rat0mu/ISP-2027RTC/hardware/boards/README.md

# 電路板專案

狀態：尚未建立設計。

實際需要一張板時，在此新增具功能名稱的子目錄，例如 primary/、backup/ 或 power/；名稱為示例，不代表已決定板數。

每張板至少包含：
- 一份清楚的現行專案入口與工具版本。
- 原理圖、PCB 與專案必要設定。
- 本板 README：用途、版號、依賴、已知問題與檢查狀態。
- 對應的電氣與機構介面文件連結。

必要庫放在共用 libraries/ 或本板明確指定的位置。自動備份不作為正式來源。正式製造資料的保存方式見 [發布檢查表](../../docs/templates/release_checklist.md)。
