rat0mu/ISP-2027RTC/docs/decisions.md

# 決策紀錄

狀態：紀錄格式。DEC-001 待 PR 審查，DEC-002 與 DEC-003 提案中，尚無經團隊審查通過的決策。

重大選擇依序新增 DEC-001、DEC-002。討論中的提案標示「提案中」，核准後才標示「採用」；被取代者保留並連向新決策。

## 決策範本

- 編號／題目：
- 日期：
- 狀態：提案中／採用／被取代
- 背景與要解決的問題：
- 考慮方案：
- 決定與理由：
- 代價與限制：
- 影響模組與後續工作：
- 相關 Issue／PR：
- 確認者：

## DEC-001 主備系統各自使用一個遙測頻段

- 編號／題目：DEC-001 主系統用 920 MHz、備援系統用 433 MHz
- 日期：2026-11-12
- 狀態：採用（使用者決定，待 PR 審查與團隊確認）
- 背景與要解決的問題：航電有 920 MHz 與 433 MHz 兩個遙測頻段，需決定由主系統與備援系統共用兩顆無線電，或各自持有一個頻段。
- 考慮方案：
  1. 兩顆無線電都放通訊層，主備系統經匯流排共用。
  2. 主系統持有 920 MHz，備援系統持有 433 MHz，各自獨立。
- 決定與理由：採用方案 2。備援的目的是獨立；共用時通訊層、匯流排或其電源一旦失效，兩個系統的遙測會同時中斷。各自持有一個頻段時，故障範圍清楚，不需要處理兩個主控爭用同一顆無線電的切換邏輯，地面也能由兩台接收端分別對應。
- 代價與限制：
  - 單一頻段失效時，該系統的資料無法改走另一個頻段。以主備互報摘要彌補，見 interfaces.md 的 COMM-001。
  - 433 MHz 模組改放備援層，天線同軸線要從堆疊下方拉到設備艙頂面，比放通訊層長。
  - 433 MHz 在台灣的使用條件與比賽規則尚未確認。
- 影響模組與後續工作：
  - 通訊層只保留 920 MHz 無線電與主系統遙測。
  - 備援層加入 433 MHz 無線電，由備援電池供電。
  - 主備之間新增一條有隔離或限流保護的序列線，互送心跳與摘要。
  - 地面站以兩台接收端分別接收兩個頻段。
- 相關 Issue／PR：待建立
- 確認者：待團隊確認

## DEC-002 主備系統感測器選型

- 編號／題目：DEC-002 主系統與備援系統的感測器選型
- 日期：2026-11-13
- 狀態：提案中
- 背景與要解決的問題：主系統與備援系統（見 DEC-001）各需一組感測器，用來判斷點火、推進結束、頂點與開傘時機，並回報位置。飛行條件為目標高度約 3.4 km（約 660 hPa）、次音速、固體馬達。
- 選型原則：
  1. 量程涵蓋 3.4 km 的氣壓與推進加速度，並留餘裕。
  2. 主備使用不同廠牌與晶片，避免同一設計缺陷或批次問題讓兩邊同時失效。
  3. 優先選擇火箭與無人機領域實績多的晶片。
  4. 備援只保留獨立判斷頂點與回報位置所需的感測器。
- 提案組合：

  | 感測器 | 主系統 | 備援系統 |
  | --- | --- | --- |
  | 氣壓計 | TE MS5611 | Bosch BMP390（或 BMP581） |
  | 慣性量測單元 | Bosch BMI088（加速度 ±24 g） | ST LSM6DSO32（加速度 ±32 g） |
  | 高 g 加速度計 | ADXL375（±200 g），選配 | 不設 |
  | 磁力計 | MEMSIC MMC5983MA，選配，僅供飛行後分析（2026-11-14 使用者選定，替代 LIS3MDL） | 不設 |
  | GNSS | u-blox M10 系列（例如 MAX-M10S），搭配自製陶瓷貼片天線 | 不同廠模組（例如 Quectel L76K），或使用 433 MHz T-Beam 的 GNSS |

- 考慮方案與理由：
  - 氣壓計：MS5611 與 BMP390 在本任務的精度差距，小於靜壓孔與遮光造成的誤差。MS5611 實績最多、量程到約 10 mbar，放在負責開傘判斷的主系統；BMP390 內建濾波與 FIFO、體積小、供貨穩定，且與主系統不同廠。若取得不到正品 MS5611，可改為主系統 BMP390、備援 Infineon DPS310。BME280 因雜訊較大未採用。
  - 慣性量測單元：BMI088 為抗振設計，適合馬達振動環境；LSM6DSO32 單顆即有 ±32 g，推力超出預期時備援仍不飽和。MPU6050、MPU9250、ICM-42688-P 因加速度量程僅 ±16 g 未採用，MPU9250 另已停產。
  - 高 g 加速度計：僅在推力或開傘衝擊超過約 24 g 時需要，依模擬結果決定。
  - GNSS：u-blox 可設定 airborne 動態模式，降低推進時失鎖機率；備援使用不同晶片，避免同一韌體問題。
- 代價與限制：
  - 規格依常見資料整理，尚未逐一以原廠規格書核對，也未確認價格與庫存。
  - 最大加速度尚未以 OpenRocket 或 RocketPy 計算；若超過約 24 g，主系統需加 ADXL375，備援量程也要重新評估。
  - MCU 提案見 DEC-003；SPI 與 I2C 數量足夠，程式庫支援尚未逐一確認。
  - MS5611 市面仿冒模組多，須由正規通路購買晶片。
- 使用注意：
  - 氣壓計以黑色泡棉遮光，並緩衝開傘壓力衝擊。
  - 鼻錐開 3 到 4 個平均分布的靜壓孔，孔徑依艙內容積計算。
  - 加速度計一軸對齊火箭長軸，盡量靠近堆疊中心。
  - 慣性量測單元優先用 SPI，氣壓計與磁力計可用 I2C。
  - 取樣率暫定：慣性量測單元 400 到 1000 Hz、氣壓計 50 到 100 Hz，定案後寫入需求表。
- 影響模組與後續工作：
  - 階段 3 先以模組或開發板驗證讀值與雜訊，再畫進 PCB。
  - 定案後補上介面規格（匯流排、位址、取樣率、單位與座標軸）。
- 相關 Issue／PR：待建立
- 確認者：待團隊確認

## DEC-003 主備系統 MCU 選型

- 編號／題目：DEC-003 主系統 STM32F405RGT6、備援系統 STM32L476RGT6
- 日期：2026-11-14
- 狀態：提案中
- 背景與要解決的問題：DEC-002 的感測器需要主控 MCU，主備各一顆。團隊希望兩邊都用 STM32，共用工具鏈與開發經驗。
- 考慮方案：
  1. 主備使用同一顆 STM32。
  2. 主備使用不同系列的 STM32。
  3. 主系統 STM32、備援 ESP32-S3（可沿用 T-Beam Supreme 上的韌體）。
- 決定與理由：提案採用方案 2。
  - 主系統 STM32F405RGT6：Cortex-M4F 168 MHz、1 MB Flash、192 KB RAM、LQFP64。有 3 組 SPI、3 組 I2C、6 組 UART、SDIO 與 USB。它是 Betaflight／INAV 飛控最常用的晶片，振動環境實績多，也能先用現成核心板或飛控驗證。
  - 備援系統 STM32L476RGT6：Cortex-M4F 80 MHz、1 MB Flash、128 KB RAM、LQFP64。有 3 組 SPI、3 組 I2C、5 組 UART 與 SDMMC。它屬低功耗系列，備援電池可撐更久；可用 Nucleo-L476RG 開發板驗證。
  - 兩顆同為 LQFP64、同一套 STM32CubeIDE 工具鏈，團隊只需熟悉一種環境；不同系列的晶粒、時脈與電源架構不同，可降低同一晶片缺陷讓兩邊同時失效的機率。
  - 方案 1 的同因失效風險最高。方案 3 的差異化最好，但要維護兩套工具鏈。
- 代價與限制：
  - 同廠牌，差異化不如方案 3；共用的 HAL 程式庫缺陷仍可能同時影響兩邊。主備的飛行判斷邏輯應各自撰寫與測試。
  - 無法直接沿用 T-Beam Supreme 上的 ESP32 韌體；T-Beam 仍可作為 433／920 MHz 的地面接收端或射頻測試工具。
  - 規格依常見資料整理，尚未逐一以原廠規格書核對，也未確認價格與庫存。
  - 腳位要等感測器與無線電介面定案後才能分配。
- 影響模組與後續工作：
  - 階段 3 以 F405 核心板與 Nucleo-L476RG 驗證感測器讀值與無線電。
  - 完成腳位分配表後，補上 interfaces.md 的相關介面。
  - 選型總表見 [元件選型總表](component_selection.md)。
- 相關 Issue／PR：待建立
- 確認者：待團隊確認

小型文字修正可留在 PR；影響架構、介面、工具鏈或正式版本的選擇，才需要在此記錄。
