rat0mu/ISP-2027RTC/docs/interfaces.md

# 介面規格草案

狀態：草案／尚未定案。

目前只有規格格式，沒有已生效的硬體或軟體介面。每項確認後透過 PR 更新，並由受影響模組的負責人確認。

| 介面 ID | 提供方 → 使用方 | 定義／單位／時序／無效值 | 版本與狀態 | 負責人 |
| --- | --- | --- | --- | --- |
| MECH-001 | 機構 → 硬體 | PCB 外形：直徑 110 mm 的馬蹄形板、板厚 1.6 mm；開槽寬 30 mm（Y 方向 ±15 mm），自 x = −24.5 mm 開到 +X 板邊，槽底兩角 R6、兩個尖端 R3；4 個 M3 螺桿孔（孔徑 3.2 mm）位於節圓 98 mm，角度 45°、135°、225°、315°；層距 13.41 mm（11.81 mm 間隔柱加板厚）；11.81 mm 是層間接頭 Samtec SFM／TFM 的標稱插合高度，間隔柱依樣品實測值訂做。座標原點為板圓心，+X 為開口側。板對板接頭佔位中心在 (13, ±36) mm，長邊沿 X：+Y 臂 2×20（主系統）、−Y 臂 2×10（備援），位置與本體尺寸未定案。來源：mechanical/cad 的 avbay v0.10（層距自 16.6 mm 改為 13.41 mm；v0.9 起電池改為沿 X 前後排列，開槽比 v0.8 窄 19 mm、深 9.5 mm，板面積約 75%） | v0.10 草案，未經確認 | 待指定 |

| RF-001 | 主系統 → 地面站 | 主遙測：920 MHz 頻段 LoRa，由主系統持有，無線電位於通訊層、由主電源供電；天線為 920 MHz 軟質天線，裝在設備艙 −Y 面的支架上往下垂掛。頻道須避開公版追蹤器（Meshtastic TW，頻率槽 1，推算約 920.125 MHz），暫定 924 MHz 附近。頻寬、擴頻因子、同步字、封包格式未定。來源：DEC-001 | 草案，未經確認 | 待指定 |
| RF-002 | 備援系統 → 地面站 | 備援遙測：433 MHz 頻段 LoRa，由備援系統持有，無線電位於備援層、由備援電池供電；天線為設備艙頂面 433 MHz 軟質天線，同軸線自備援層拉到頂面。頻率、功率與法規條件未確認。來源：DEC-001 | 草案，未經確認 | 待指定 |
| COMM-001 | 主系統 ↔ 備援系統 | 互報序列線：雙方定時互送心跳與摘要（高度、飛行狀態、電壓），各自的遙測封包附上對方最後一筆摘要。須有隔離或限流，一方短路、當機或斷電不得影響另一方。實體層、速率、欄位、逾時未定。來源：DEC-001 | 草案，未經確認 | 待指定 |

建立介面時按用途選填：

- 電氣：供電、電平、接頭、腳位與限制。
- 通訊：傳輸方式、欄位、位元組順序、版本、校驗與逾時。
- 資料：單位、座標軸、時間基準、更新率與無效值。
- 機構：尺寸、孔位、接頭空間、裝配與維修空間。
- 驗證：如何確認雙方實作符合介面。

介面變更時列出受影響模組、相容性、遷移方式與驗證需求。
