rat0mu/ISP-2027RTC/firmware/README.md

# MCU 韌體

狀態：尚未建立實作。

確定 MCU 與工具鏈後，再建立可獨立建置的專案。主備若使用不同 MCU，先保留各自完整建置入口；共用邏輯穩定後再抽出。

第一份實作加入時請填寫：
- MCU、對應硬體版本與專案入口。
- 工具鏈版本與新環境建置步驟。
- 建置命令、角色／profile、輸出位置。
- 本機路徑設定方式。
- 可執行測試與尚未驗證事項。

不同角色使用獨立輸出目錄。避免透過反覆改寫共同來源檔來切角色。

## 放置位置

- [targets/](targets/README.md)：各 MCU／硬體目標的獨立專案。
- [common/](common/README.md)：已有明確需求後抽出的共用邏輯。
