rat0mu/ISP-2027RTC/ground_station/README.md

# PC 地面站

狀態：尚未建立實作。

未來放 PC 端的串口連線、封包解碼、GUI 與操作說明。接收器硬體放 hardware/；接收器 MCU 韌體放 firmware/。

第一份實作加入時請填寫：
- 主要啟動入口、語言版本與相依安裝方式。
- 可接受的封包／韌體版本。
- 測試資料與離線使用方式。
- log、報告與其他自動產物的位置。
- 操作限制與已知問題。

共用解碼規則集中管理。執行產物預設放 logs/ 或 reports/，必要測試樣本另行保留。
