rat0mu/ISP-2027RTC/tools/README.md

# 輔助工具

目前提供 check_docs.py：檢查本地 Markdown 連結與支援的標題錨點。

在 repo 根目錄使用 Python 3.10 以上執行 python tools/check_docs.py。詳細用法與限制見 [文件自動檢查](../docs/automation.md)。

未來增加建置、解碼或分析工具時，補充輸入、輸出、相依與執行方式，使用可設定路徑；臨時產物放 output/。
