rat0mu/ISP-2027RTC/hardware/datasheets/README.md

# 硬體參考資料

狀態：尚無規格書。

加入資料時記錄完整料號、製造商、文件版本、官方來源與取得日期。檔名使用可辨識的料號與用途；相關設計筆記註明使用的文件版本或頁碼。

保持必要且可追溯的資料，避免重複放入同一份規格書。
