rat0mu/ISP-2027RTC/docs/templates/README.md

# 文件範本

複製適用範本到負責模組或對應測試紀錄的位置，填入真實資訊後提交。待填欄位不是已完成成果。

- [設計說明](design_note.md)
- [測試紀錄](test_report.md)
- [里程碑發布檢查表](release_checklist.md)
