rat0mu/ISP-2027RTC/firmware/common/README.md

# 共用邏輯

狀態：尚無共用實作。

當兩個以上實際目標需要相同邏輯，而且介面已清楚時，再將共用程式放入此處。不要為了填滿目錄預先建立空白驅動或偽造可建置的韌體。

適合的內容可能是封包、資料轉換或可離板驗證的演算法；各目標的腳位、周邊與硬體存取維持明確邊界。加入後提供介面與對應測試。
