rat0mu/ISP-2027RTC/firmware/targets/README.md

# MCU 目標專案

狀態：尚未建立實作。

確定 MCU 與板版號後，每個可獨立建置的目標放一個子目錄。名稱依用途命名，並寫出硬體對應、工具鏈版本、產生設定的方式與建置入口。

不同角色與組態使用不同輸出目錄。若依賴工具自動生成檔案，提供從乾淨 clone 重建的步驟，不能只依賴成員本機保留的 Debug/ 目錄。
