rat0mu/ISP-2027RTC/docs/templates/design_note.md

# 設計說明：待填

- 狀態：草案
- 負責人／審查人：待填
- 適用來源版本：待填
- 關聯 Issue／PR：待填

## 目的與範圍

要解決的問題、使用條件與範圍。

## 方案與理由

比較方案、採用理由、代價與限制。

## 介面與依賴

受影響模組、來源、單位、尺寸、版本與相容性。

## 驗證

驗收條件、方法、已執行結果與尚未完成事項。

## 後續工作

剩餘問題、負責人與追蹤位置。
