rat0mu/ISP-2027RTC/docs/team.md

# 團隊與責任

狀態：待指定。下表為角色位置，不代表已分配任何成員。

| 模組／職責 | 負責人 GitHub 帳號 | 備援／審查人 | 備註 |
| --- | --- | --- | --- |
| Repo 維護與整合 | 待指定 | 待指定 | 權限、流程與版本管理 |
| 硬體 | 待指定 | 待指定 | 電路、PCB 與零件庫 |
| 韌體 | 待指定 | 待指定 | MCU 程式與建置 |
| 地面站 | 待指定 | 待指定 | PC 軟體與資料解碼 |
| 機構 | 待指定 | 待指定 | 航電艙與裝配 |
| 測試與文件 | 待指定 | 待指定 | 驗收證據與文件一致性 |

負責人維護模組介面並協調整合；任務執行者可由不同成員擔任。每個 Issue 仍需個別指定執行者與審查人。

團隊分工變更時透過 PR 更新本文件。CODEOWNERS 目前只有未啟用範例，填入真實帳號後才啟用。
