rat0mu/ISP-2027RTC/docs/templates/release_checklist.md

# 里程碑發布檢查表

範本狀態：尚未對應任何已完成的發布。

- 里程碑名稱／目的：待填
- 整合負責人／審查人：待填
- 來源 commit／預計 tag：待填
- 適用範圍：文件／桌面測試／板級／整機／其他（選填）
- 必要驗證與已知限制：待填

## 發布前確認

- [ ] 範圍與通過條件明確。
- [ ] 檔案、依賴與介面文件互相對應。
- [ ] 實際測試有版本、組態與證據。
- [ ] 硬體製造資料對應確切來源（適用時）。
- [ ] 各韌體角色與地面站的版本／產物／組態可辨識（適用時）。
- [ ] 未完成項與已知問題已列出。
- [ ] 已由其他成員審查。

## 發布紀錄

填寫實際 tag、發布說明、產物與證據位置。所有勾選基於真實驗收；文件檢查不能代替板級或整機驗證。
