rat0mu/ISP-2027RTC/docs/figures/battery_concept.png

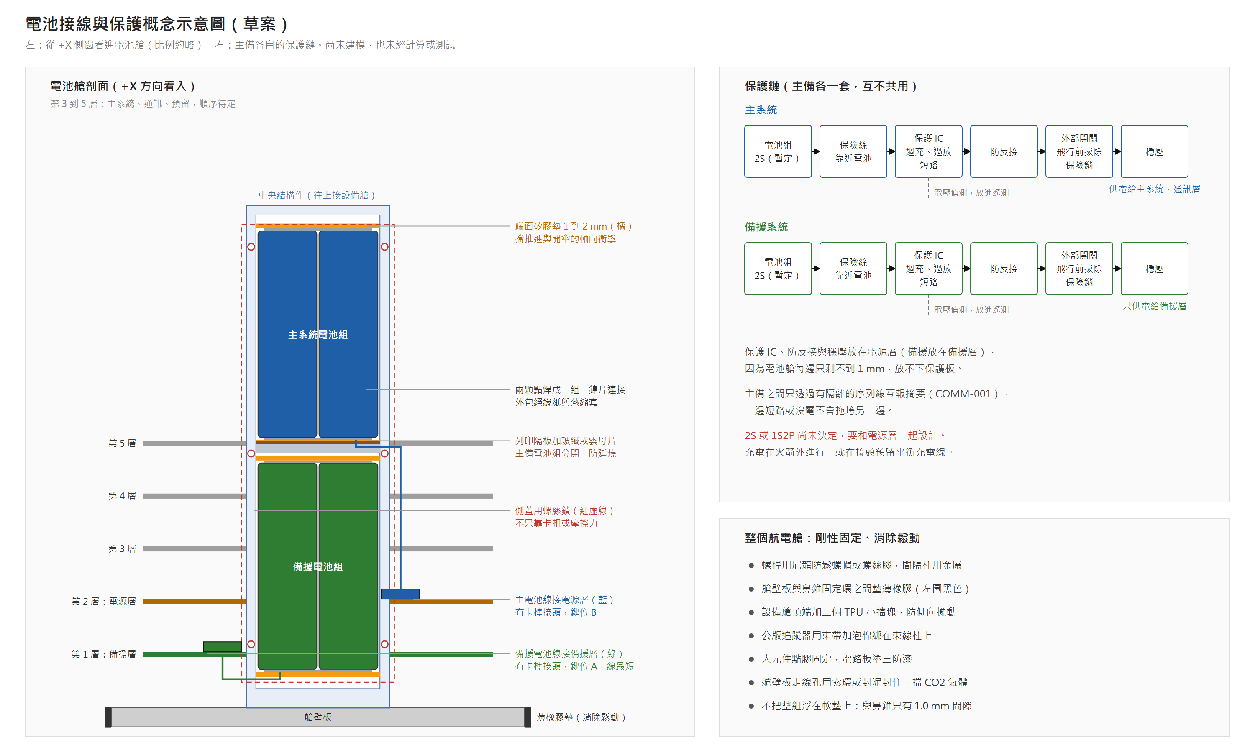
docs/figures/battery_concept.png
