rat0mu/ISP-2027RTC/docs/mission_patch/mission_patch_v1.png

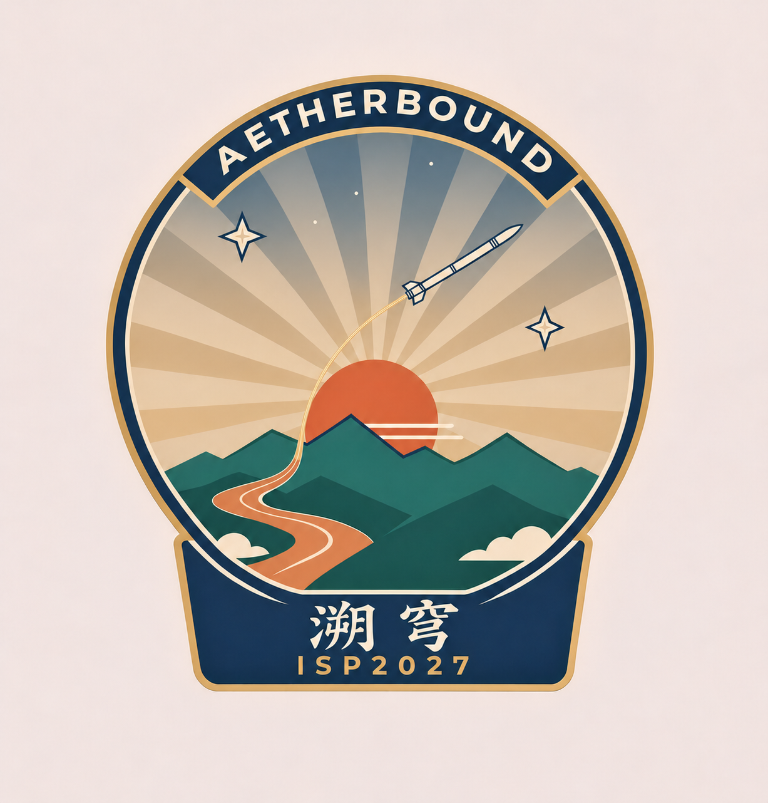
docs/mission_patch/mission_patch_v1.png
