rat0mu/ISP-2027RTC/mechanical/cad/avbay_v0_10_view_open_side.png

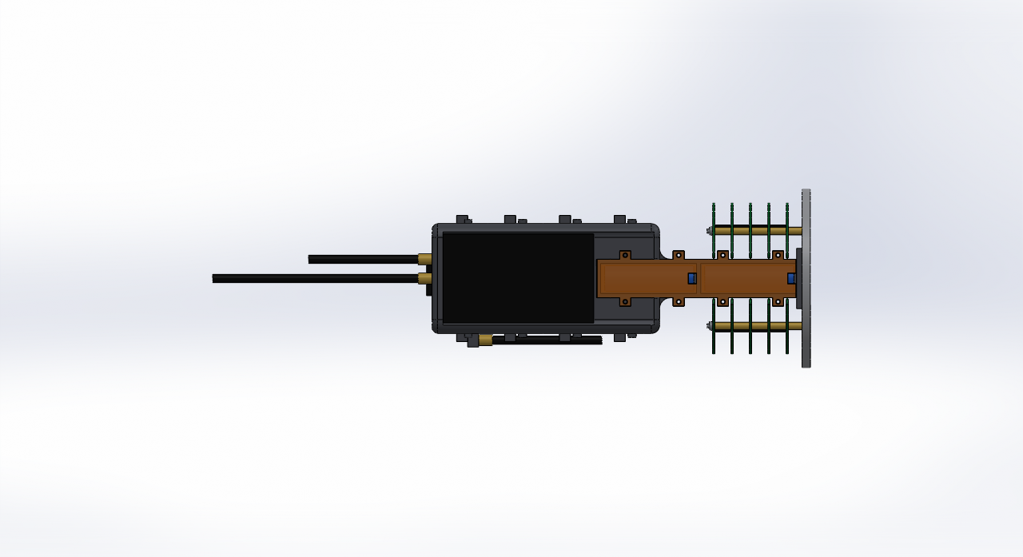
mechanical/cad/avbay_v0_10_view_open_side.png
