rat0mu/ISP-2027RTC/docs/component_selection.md

# 元件選型總表

狀態：草案。最後更新：2026-11-14。

本表列出主系統與備援系統目前的元件選擇，方便隨時查看與修改。選擇的理由與代價寫在 [設計決策](decisions.md)；本表只放結論。

## 如何修改

1. 直接修改下表對應的格子，並更新上方的「最後更新」日期。
2. 狀態欄只用以下四種：
   - 候選：還在比較，尚未寫成決策。
   - 提案中：已寫入 decisions.md，待團隊確認。
   - 採用：團隊已確認。
   - 已取代：保留原列，並在備註寫出換成什麼與原因。
3. 換掉提案中或採用的元件時，同步修改 decisions.md 對應的決策；影響架構或介面時，一併更新 [系統架構](architecture.md) 與 [介面規格](interfaces.md)。
4. 在下方「修改紀錄」加一行。

## 主系統（920 MHz）

| 項目 | 選擇 | 介面 | 替代方案 | 狀態 | 依據 | 備註 |
| --- | --- | --- | --- | --- | --- | --- |
| MCU | STM32F405RGT6 | — | STM32G474RET6 | 提案中 | DEC-003 | LQFP64；可先用 F405 核心板或飛控驗證 |
| 氣壓計 | TE MS5611 | SPI | BMP390 | 提案中 | DEC-002 | 須由正規通路購買，避免仿冒 |
| 慣性量測單元 | Bosch BMI088 | SPI | — | 提案中 | DEC-002 | 加速度 ±24 g；加速度與陀螺各一條 CS |
| 高 g 加速度計 | ADXL375（選配） | SPI | 不設 | 提案中 | DEC-002 | ±200 g；依最大加速度模擬決定 |
| 磁力計 | MEMSIC MMC5983MA（選配） | I2C | LIS3MDL | 提案中 | DEC-002 | 僅供飛行後分析；2026-11-14 由使用者選定 |
| GNSS | u-blox M10（例如 MAX-M10S） | UART | — | 提案中 | DEC-002 | 設定 airborne 動態模式；搭配自製陶瓷貼片天線 |
| 無線電 | Ebyte E22-900M22S（SX1262） | SPI | E22-900T22S（UART） | 候選 | DEC-001（頻段） | 920–925 MHz；模組型號尚未寫成決策 |
| 資料記錄 | microSD | SDIO | SPI NOR Flash | 候選 | — | 尚未決策 |

## 備援系統（433 MHz）

| 項目 | 選擇 | 介面 | 替代方案 | 狀態 | 依據 | 備註 |
| --- | --- | --- | --- | --- | --- | --- |
| MCU | STM32L476RGT6 | — | ESP32-S3、RP2350 | 提案中 | DEC-003 | LQFP64 低功耗系列；可用 Nucleo-L476RG 驗證 |
| 氣壓計 | Bosch BMP390 | SPI 或 I2C | BMP581、DPS310 | 提案中 | DEC-002 | 與主系統不同廠 |
| 慣性量測單元 | ST LSM6DSO32 | SPI | — | 提案中 | DEC-002 | 加速度 ±32 g |
| GNSS | Quectel L76K | UART | 其他非 u-blox 模組 | 提案中 | DEC-002 | 與主系統不同晶片 |
| 無線電 | Ebyte E22-400M22S（SX1268） | SPI | E22-400T22S（UART） | 候選 | DEC-001（頻段） | 433 MHz 在台灣的使用條件尚未確認 |
| 資料記錄 | SPI NOR Flash | SPI | microSD | 候選 | — | 尚未決策 |

## 主備共用

| 項目 | 選擇 | 介面 | 狀態 | 依據 | 備註 |
| --- | --- | --- | --- | --- | --- |
| 主備互報 | 序列線，含隔離或限流保護 | UART | 提案中 | COMM-001、DEC-001 | 互送心跳與摘要 |
| 層間連接 | Samtec SFM（插座，板頂面）＋ TFM（插針，板底面），1.27 mm 雙排、表面黏著、腳型 -32、插合高度 11.81 mm、加鎖扣選項；兩臂各一組（HAMSTER 式）：主系統臂 2×20，備援臂 2×10 | 板對板 | 候選 | — | 2026-11-14 使用者選定。層距改為 13.41 mm（11.81 加板厚 1.6），間隔柱須訂做為實測插合高度；料號格式約為 TFM-120-32-S-D-LC，SFM 腳型代碼與鎖扣選項待以原廠規格書確認；替代方案 Samtec FW＋CLP（高度可調，無鎖扣）；針數為估算 |
| 電池 | 18650 ×4 | — | 候選 | — | 2S 或 1S2P 尚未決定 |

## 待確認

- 最大加速度模擬結果：決定是否加 ADXL375，以及備援量程是否足夠。
- 各元件規格、價格與庫存：尚未逐一以原廠規格書與通路核對。
- 腳位分配：待介面定案後建立。

## 修改紀錄

| 日期 | 修改內容 |
| --- | --- |
| 2026-11-14 | 建立總表；加入 DEC-003 的 MCU 提案 |
| 2026-11-14 | 磁力計定為 MMC5983MA，LIS3MDL 改列替代方案 |
| 2026-11-14 | 加入層間連接：1.27 mm 板對板堆疊接頭，主臂 2×20、備援臂 2×10 |
| 2026-11-14 | 層間連接選定 Samtec SFM／TFM，插合高度 11.81 mm，層距改為 13.41 mm |
| 2026-11-14 | CAD 更新為 avbay v0.10：層距 13.41 mm、接頭佔位 2×20 與 2×10 |
