rat0mu/ISP-2027RTC/mechanical/cad/fitcheck_avbay_v0_10_assembly_in_NOSE_v1.SLDASM

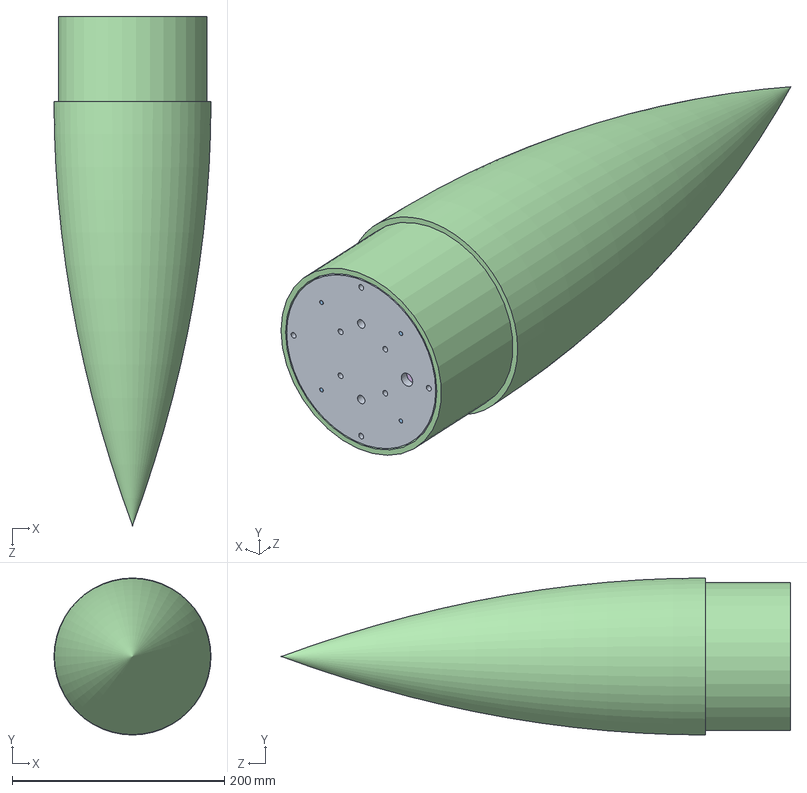
[picture p8: CAD file, 2026-11-14]
mechanical/cad/fitcheck_avbay_v0_10_assembly_in_NOSE_v1.SLDASM
148.0 x 148.0 x 480.0 mm
avbay_v0_10_bulkhead
avbay_v0_10_spine
avbay_v0_10_rod_m3 x 4
avbay_v0_10_spacer_m3_10 x 4
avbay_v0_10_nut_m3 x 4
avbay_v0_10_pcb_outline x 5
avbay_v0_10_spacer_m3_stack x 16
avbay_v0_10_stack_connector_2x20 x 4
avbay_v0_10_stack_connector_2x10 x 4
avbay_v0_10_cell_18650 x 4
avbay_v0_10_cell_cover
avbay_v0_10_cap
avbay_v0_10_gps_board
avbay_v0_10_sma_base x 3
avbay_v0_10_ant_433
avbay_v0_10_ant_tracker
avbay_v0_10_ant_920
avbay_v0_10_gnss_patch
avbay_v0_10_tracker
NOSE_v1
