rat0mu/ISP-2027RTC/mechanical/cad/avbay_v0_10_rod_m3.SLDPRT

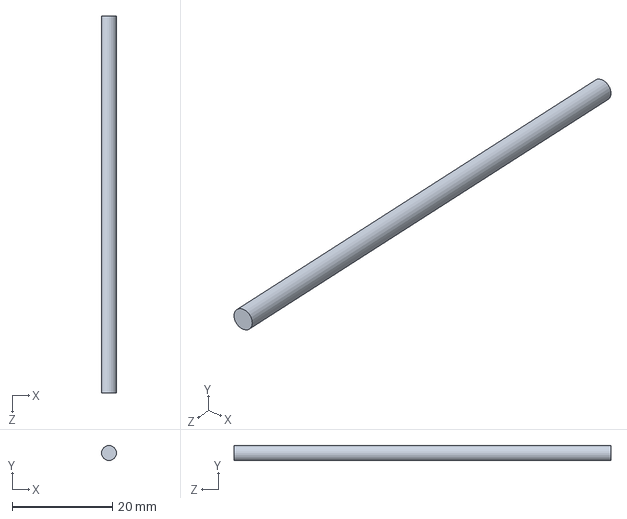
[picture p10: CAD file, 2026-11-14]
mechanical/cad/avbay_v0_10_rod_m3.SLDPRT
3.00 x 3.00 x 75.2 mm
