rat0mu/ISP-2027RTC/mechanical/cad/avbay_v0_10_cell_18650.SLDPRT

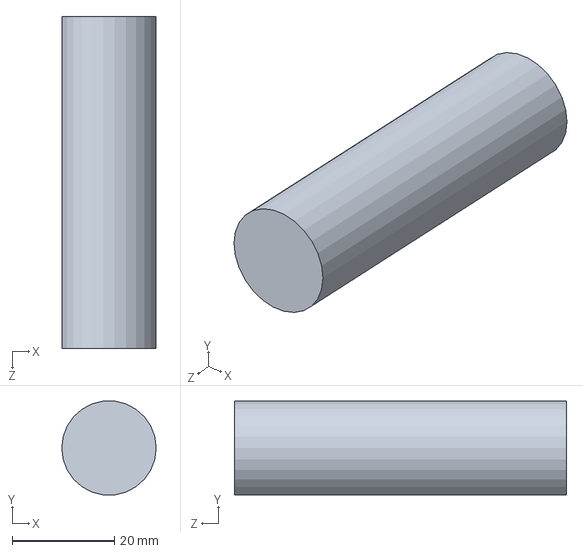
[picture p11: CAD file, 2026-11-14]
mechanical/cad/avbay_v0_10_cell_18650.SLDPRT
18.5 x 18.4 x 65.0 mm
