rat0mu/ISP-2027RTC/mechanical/cad/avbay_v0_10_gps_board.SLDPRT

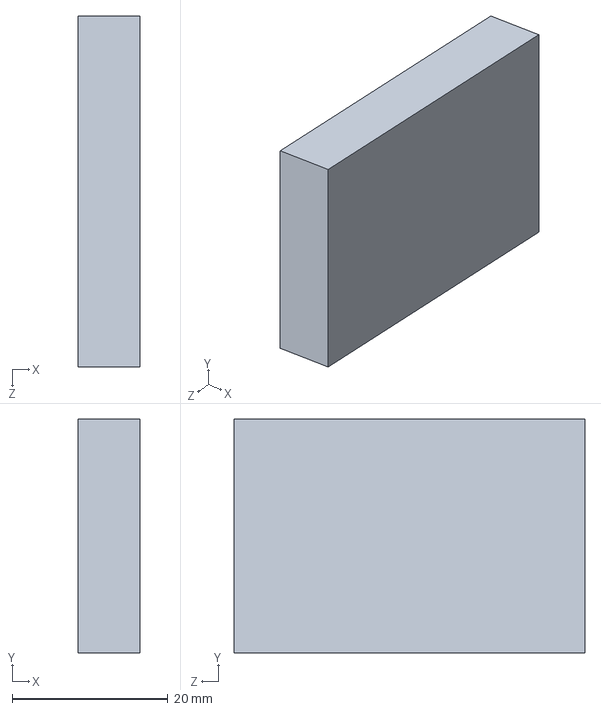
[picture p12: CAD file, 2026-11-14]
mechanical/cad/avbay_v0_10_gps_board.SLDPRT
8.00 x 30.0 x 45.0 mm
