rat0mu/ISP-2027RTC/mechanical/cad/avbay_v0_10_cell_cover.SLDPRT

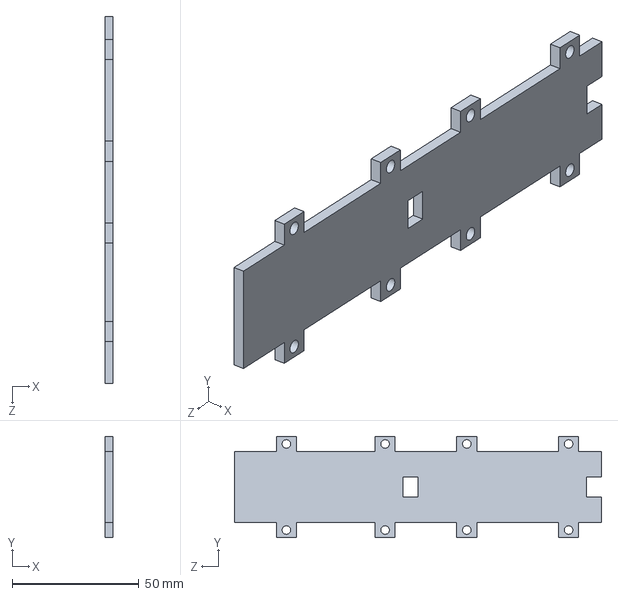
[picture p14: CAD file, 2026-11-14]
mechanical/cad/avbay_v0_10_cell_cover.SLDPRT
3.00 x 40.0 x 145.0 mm
