rat0mu/ISP-2027RTC/mechanical/cad/avbay_v0_10_gnss_patch.SLDPRT

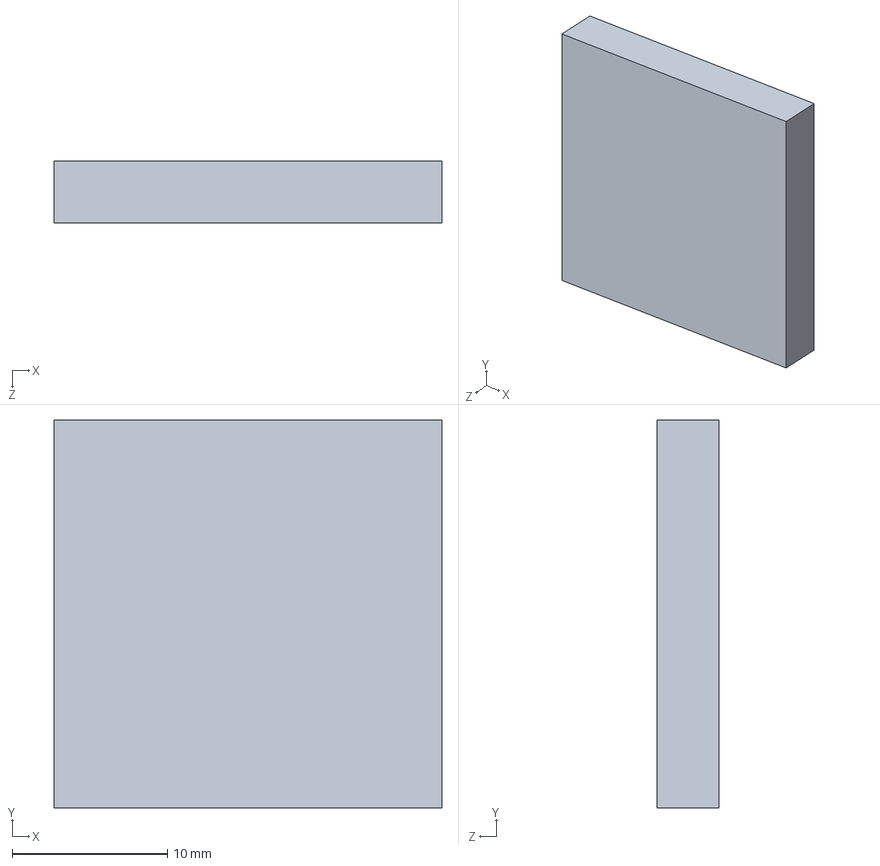
[picture p15: CAD file, 2026-11-14]
mechanical/cad/avbay_v0_10_gnss_patch.SLDPRT
25.0 x 25.0 x 4.00 mm
