rat0mu/ISP-2027RTC/mechanical/cad/avbay_v0_10_ant_tracker.SLDPRT

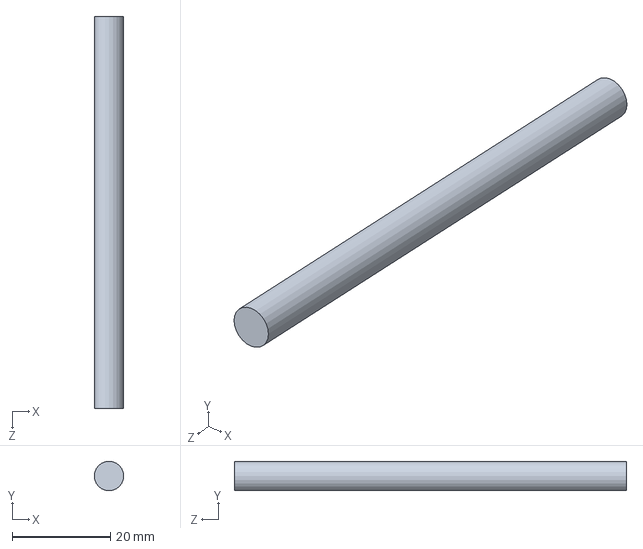
[picture p16: CAD file, 2026-11-14]
mechanical/cad/avbay_v0_10_ant_tracker.SLDPRT
6.00 x 6.00 x 80.0 mm
