rat0mu/ISP-2027RTC/mechanical/cad/avbay_v0_10_spine.SLDPRT

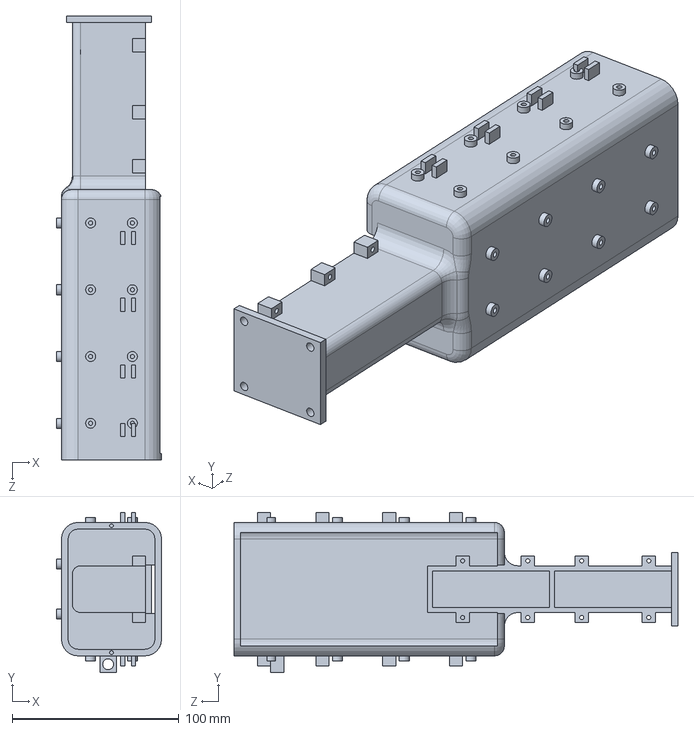
[picture p17: CAD file, 2026-11-14]
mechanical/cad/avbay_v0_10_spine.SLDPRT
63.0 x 96.0 x 266.0 mm
