rat0mu/ISP-2027RTC/mechanical/cad/avbay_v0_10_stack_connector_2x20.SLDPRT

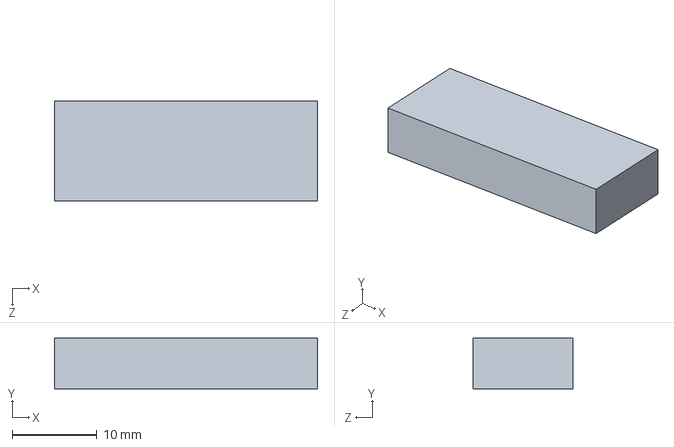
[picture p18: CAD file, 2026-11-14]
mechanical/cad/avbay_v0_10_stack_connector_2x20.SLDPRT
31.0 x 6.00 x 11.8 mm
