rat0mu/ISP-2027RTC/mechanical/cad/avbay_v0_10_bulkhead.SLDPRT

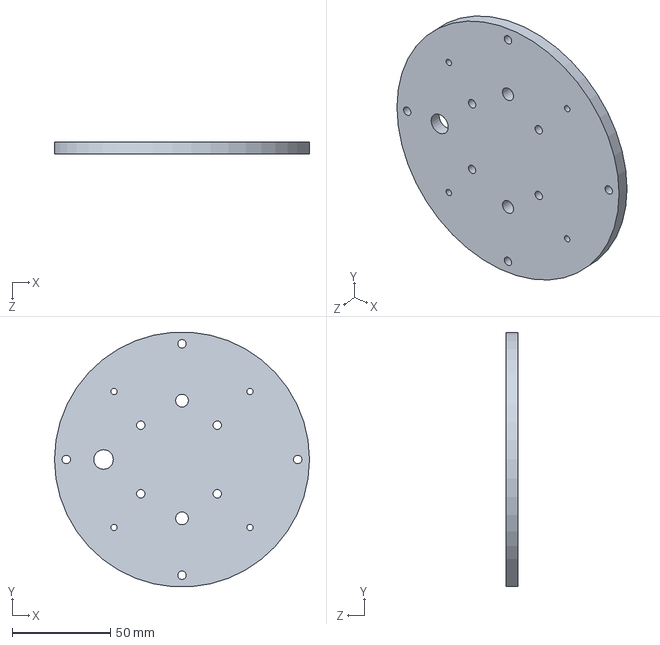
[picture p19: CAD file, 2026-11-14]
mechanical/cad/avbay_v0_10_bulkhead.SLDPRT
130.0 x 129.6 x 6.00 mm
