rat0mu/ISP-2027RTC/mechanical/cad/avbay_v0_10_spacer_m3_10.SLDPRT

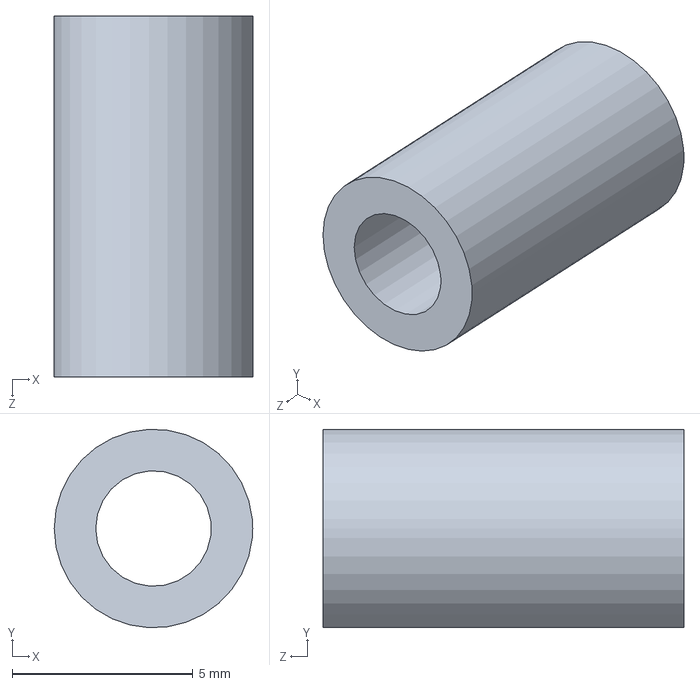
[picture p20: CAD file, 2026-11-14]
mechanical/cad/avbay_v0_10_spacer_m3_10.SLDPRT
5.50 x 5.49 x 10.0 mm
