rat0mu/ISP-2027RTC/mechanical/cad/NOSE_v1.SLDPRT

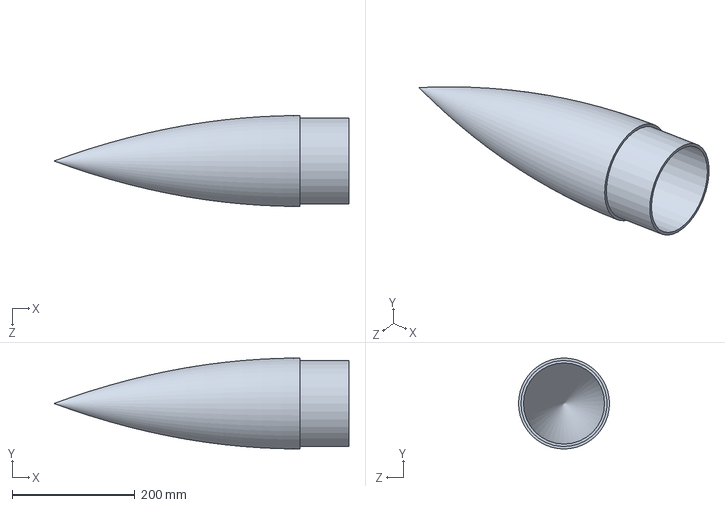
[picture p21: CAD file, 2026-11-14]
mechanical/cad/NOSE_v1.SLDPRT
480.0 x 148.0 x 148.0 mm
