rat0mu/ISP-2027RTC/mechanical/cad/avbay_v0_10_sma_base.SLDPRT

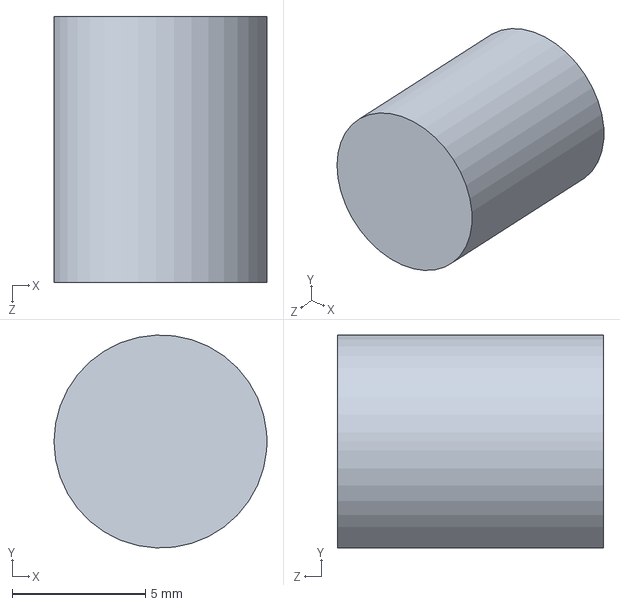
[picture p22: CAD file, 2026-11-14]
mechanical/cad/avbay_v0_10_sma_base.SLDPRT
8.00 x 7.99 x 10.0 mm
