rat0mu/ISP-2027RTC/mechanical/cad/avbay_v0_10_ant_433.SLDPRT

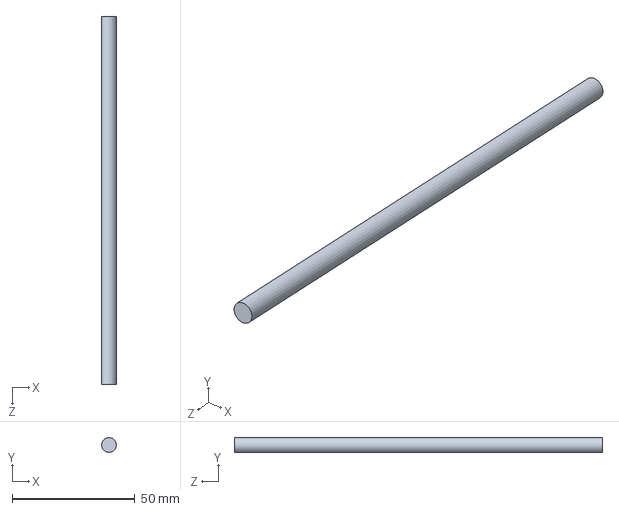
[picture p23: CAD file, 2026-11-14]
mechanical/cad/avbay_v0_10_ant_433.SLDPRT
6.00 x 6.00 x 150.0 mm
