rat0mu/ISP-2027RTC/mechanical/cad/avbay_v0_10_tracker.SLDPRT

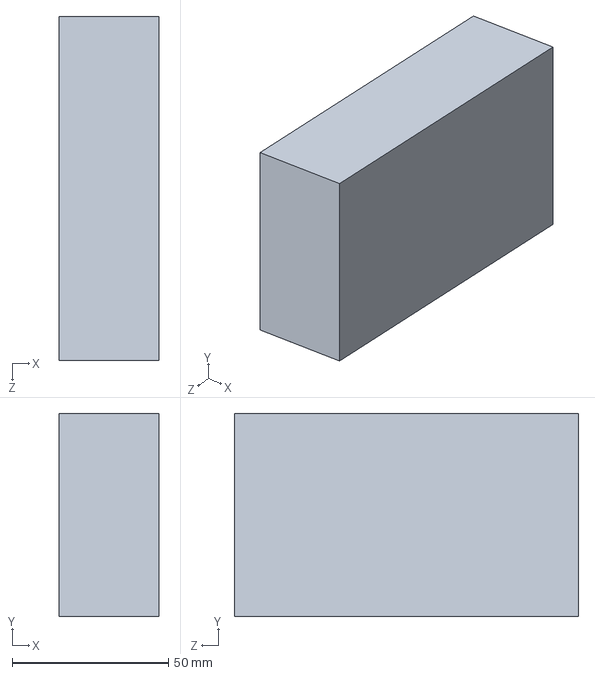
[picture p24: CAD file, 2026-11-14]
mechanical/cad/avbay_v0_10_tracker.SLDPRT
32.0 x 65.0 x 110.0 mm
