rat0mu/ISP-2027RTC/mechanical/cad/avbay_v0_10_pcb_outline.SLDPRT

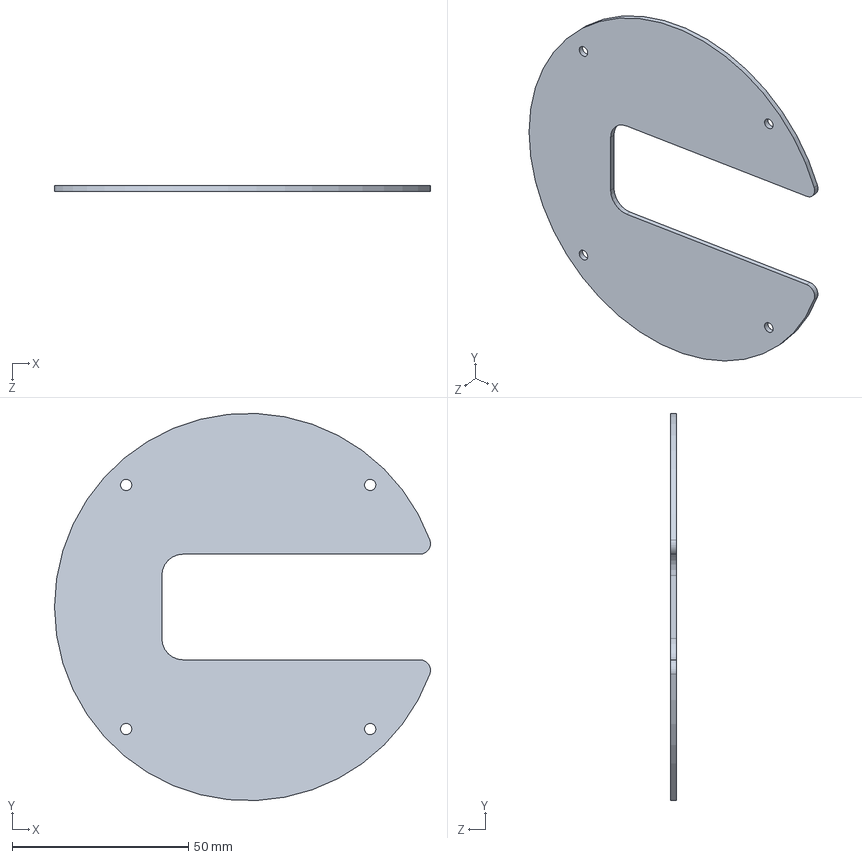
[picture p25: CAD file, 2026-11-14]
mechanical/cad/avbay_v0_10_pcb_outline.SLDPRT
106.8 x 109.9 x 1.60 mm
