rat0mu/ISP-2027RTC/mechanical/cad/avbay_v0_10_stack_connector_2x10.SLDPRT

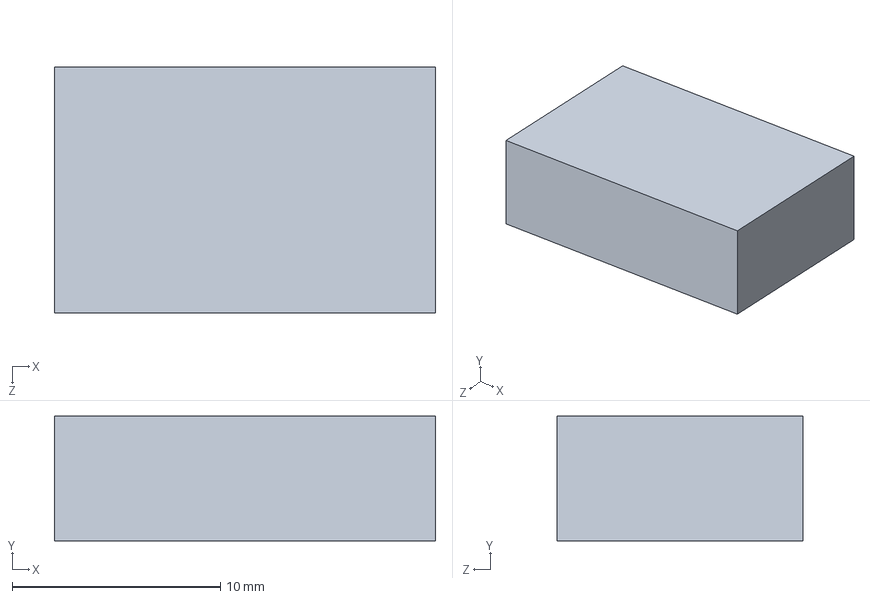
[picture p26: CAD file, 2026-11-14]
mechanical/cad/avbay_v0_10_stack_connector_2x10.SLDPRT
18.3 x 6.00 x 11.8 mm
