rat0mu/ISP-2027RTC/mechanical/cad/avbay_v0_10_cap.SLDPRT

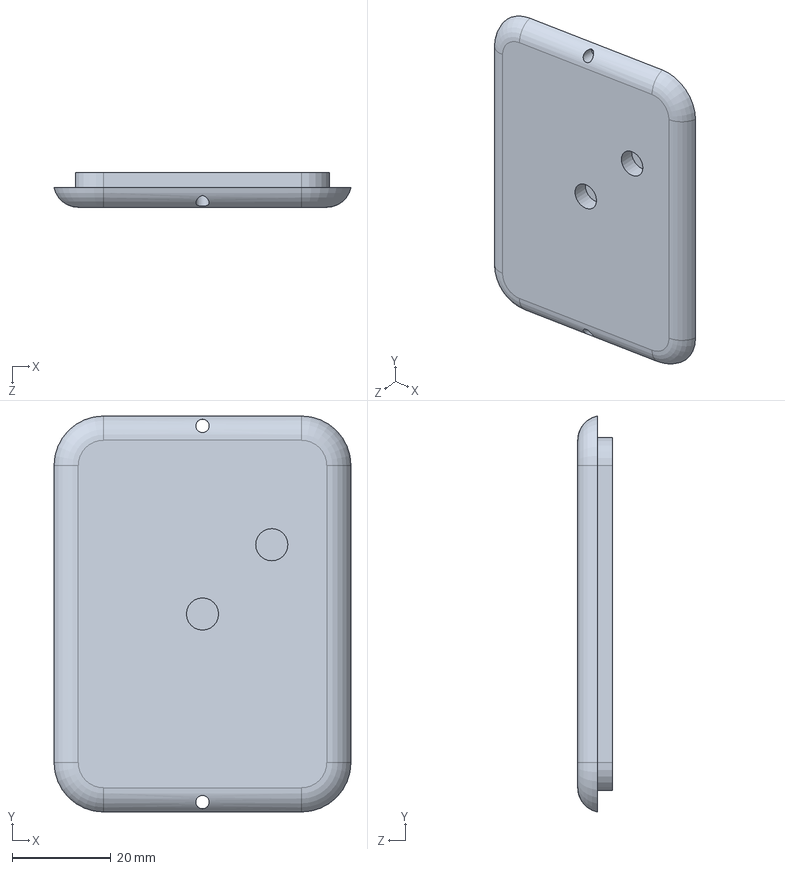
[picture p27: CAD file, 2026-11-14]
mechanical/cad/avbay_v0_10_cap.SLDPRT
60.0 x 80.0 x 7.00 mm
