rat0mu/ISP-2027RTC/(list of files, cad)

Other CAD files:
mechanical/cad/avbay_v0_10_ant_920.SLDPRT
mechanical/cad/avbay_v0_10_nut_m3.SLDPRT
