rat0mu/ISP-2027RTC/tests/README.md

# 測試

狀態：尚無測試程式與結果。

未來放可重複執行的測試與小型必要輸入。自動化 host 邏輯測試、板級驗證與整機驗證分開說明。

每個測試加入時記錄：
- 驗證目標與關聯需求。
- 執行命令與相依環境。
- 預期結果與通過條件。
- 對應來源版本與測試資料。
- 失敗時是否回傳非零退出碼。

CI 建立前先在另一位組員的環境重現測試。需要的 CSV 樣本可進版控；臨時輸出放 output/。不要以固定成功退出的診斷程式作為合併檢查。

必要小型輸入放在 [fixtures/](fixtures/README.md)。本模板已有 [文件連結檢查](../docs/automation.md)，但尚無航電功能測試。測試紀錄格式見 [範本](../docs/templates/test_report.md)。
