rat0mu/ISP-2027RTC/tests/fixtures/README.md

# 必要測試輸入

狀態：尚無樣本。

存放可重現測試所需的小型資料。每份資料記錄來源、格式、單位、對應測試與預期結果。

明確區分實測、模擬與人工合成資料。CSV 不會被全域忽略；大型原始量測另確認保存方式。測試產物放 tests/output/。
