rat0mu/ISP-2027RTC/docs/templates/test_report.md

# 測試紀錄：待填

- 測試 ID／日期：待填
- 執行者／審查人：待填
- 來源 commit：待填
- 硬體版本／組態／工具：待填
- 關聯需求／Issue：待填
- 資料種類：實測／模擬／人工合成（選填真實種類）

## 目標與驗收條件

記錄可判定結果的條件與單位。

## 方法與環境

前置條件、步驟、輸入、儀器與限制。

## 結果

預期、實際結果、證據位置與異常。沒執行時明確寫尚未執行。

## 結論

通過／未通過／待確認，並說明適用範圍。

## 後續處理

問題、負責人與關聯任務。
