rat0mu/ISP-2027RTC/docs/troubleshooting.md

# 常見問題

本文件提供操作與說明；協作要求以 [CONTRIBUTING.md](../CONTRIBUTING.md) 為準。

### commit 與 push 有什麼不同？

commit 是本機版本紀錄，push 才把提交傳到遠端。push 到任務分支後，成果仍需經 PR 合併才會進入 main。

### git pull origin main 會切到 main 嗎？

不會。它會取得遠端 main 並整合進目前所在分支。先用 git branch --show-current 確認位置；要更新本機 main，先切換至 main。

### 為什麼不直接在 main 開發？

任務分支提供修改與討論空間，PR 留下審查與驗收紀錄，讓其他成員從共同 main 取得已接受的成果。首次建立模板的初始提交，依初始化指南處理。

### git push 失敗怎麼辦？

先讀完整錯誤，確認是版本落後、權限、認證、分支名稱、保護規則或檔案限制。不要一律重複 pull，也不要用 force push 覆蓋共同分支。

若是同一任務分支遠端已有新提交，先確認自己的工作已保存，再整合該分支；若 main 更新，使用 fetch 後將 main 整合進任務分支。

### 發生 merge 衝突怎麼辦？

用 git status 找衝突檔，理解兩邊改動後解決，再檢查、暫存與完成 merge。程式重新建置／測試；硬體與機構重新開啟檢查。需要取消尚未完成的 merge 可用 git merge --abort。開始整合前先保存既有工作。

### 不小心把檔案加入暫存，還沒 commit，怎麼取消？

```bash
git restore --staged README.md
```

把 README.md 換成實際路徑。此操作取消暫存，保留工作目錄的修改。

### 目前沒有測試程式，PR 要怎麼填？

文件任務可記錄連結檢查、閱讀審查或操作演練。若某類測試不適用，說明原因；若需要但還沒做，標明尚未執行。之後有實作再補適當測試。

### 需要一開始就建立 develop、release 與每人的長期分支嗎？

目前使用 main 加任務分支。當實際整合與維護需求出現，再由團隊決定其他長期分支的用途與維護責任。

### CODEOWNERS 範例現在會自動指定審查人嗎？

不會。目前是 CODEOWNERS.example。填入實際且具權限的帳號、改為有效檔名後才會作用；若要強制核准，還要設定 GitHub 對應保護條件。

### 沒有內容，為什麼目錄裡有 README？

Git 不追蹤空目錄。各目錄 README 同時保留目錄並說明未來用途；實際加入內容後，更新入口與使用方式。

返回 [文件索引](README.md)。
