rat0mu/ISP-2027RTC/(commit log)

2026-11-10 feat: 新增航電艙概念模型 avbay v0.4 與建模腳本
    - mechanical/cad：SOLIDWORKS 2018 的零件、組合件與三張預覽圖。
    馬蹄形電路板以四支 M3 螺桿加間隔柱固定；中央列印脊柱內放四顆
    18650，上半部為兩段圓角過渡的設備艙。
    - mechanical/cad/build_avbay.py：透過 SOLIDWORKS COM API 產生上述
    檔案的參數化腳本。
    - docs/interfaces.md：新增草案介面 MECH-001（PCB 外形與孔位）。
    - .gitignore：忽略 SOLIDWORKS 開檔時的 ~$ 鎖定檔。
    驗證：僅完成 SOLIDWORKS 干涉檢查（0 處）。鼻錐輪廓由示意圖換算，
    對鼻錐的間隙為計算值；強度、列印可行性與實體試裝尚未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
    [avbay_v0_4_assembly.SLDASM, avbay_v0_4_bulkhead.SLDPRT, avbay_v0_4_cell_18650.SLDPRT, avbay_v0_4_nut_m3.SLDPRT, avbay_v0_4_pcb_outline.SLDPRT, avbay_v0_4_rod_m3.SLDPRT, avbay_v0_4_spacer_m3_10.SLDPRT, avbay_v0_4_spacer_m3_15.SLDPRT]
2026-11-10 feat: 航電艙概念模型更新至 avbay v0.7，依實際鼻錐 NOSE_v1 修正
    - 加入團隊提供的鼻錐 NOSE_v1.SLDPRT，艙壁板依肩部內徑 132 縮為 130。
    - 設備艙改為單段 60×80 等截面（z 110 至 276），台灣盃公版 GPS 追蹤器
    （Rocket Beacon，尺寸由技術資料圖片估計）直立於艙內，由 +X 開口取放。
    - 參考 USCRPL HAMSTER 實物：三個外側面加 M3 自攻凸台與束線柱，頂蓋改為
    可拆零件並裝三支軟質天線（433、920、追蹤器 LoRa）與自製 GPS 貼片，
    自製 GPS 板佔位鎖在 −X 面。
    - 新增 fitcheck_nose.py：把航電艙放進鼻錐跑干涉檢查並輸出間隙報告。
    - 移除 v0.4 檔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
    [NOSE_v1.SLDPRT, avbay_v0_4_assembly.SLDASM, avbay_v0_4_bulkhead.SLDPRT, avbay_v0_4_cell_18650.SLDPRT, avbay_v0_4_nut_m3.SLDPRT, avbay_v0_4_pcb_outline.SLDPRT, avbay_v0_4_rod_m3.SLDPRT, avbay_v0_4_spacer_m3_10.SLDPRT]
2026-11-13 feat: 航電艙更新至 avbay v0.8，新增頻段與感測器決策及研發路徑圖
    機構
    - 電池槽每邊放大 1 mm 供緩衝套使用（槽內 41 x 22）
    - 新增以 8 顆 M3 螺絲固定的電池槽側蓋與脊柱凸耳
    - PCB 開槽改為寬 49、自 x = -15（MECH-001 同步更新）
    - 以 v0.8 檔案取代 v0.7；SOLIDWORKS 干涉檢查 0 處，裝入 NOSE_v1 亦為 0 處
    文件
    - DEC-001：主系統用 920 MHz、備援系統用 433 MHz
    - DEC-002：主備感測器選型（提案中）
    - 介面草案 RF-001、RF-002、COMM-001
    - 新增航電研發路徑圖、研發流程圖、電池接線與保護示意圖
    未執行：強度、列印可行性、實體試裝、射頻量測。
    Co-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
    [avbay_v0_7_ant_433.SLDPRT, avbay_v0_7_ant_920.SLDPRT, avbay_v0_7_ant_tracker.SLDPRT, avbay_v0_7_assembly.SLDASM, avbay_v0_7_bulkhead.SLDPRT, avbay_v0_7_cap.SLDPRT, avbay_v0_7_cell_18650.SLDPRT, avbay_v0_7_gnss_patch.SLDPRT]
2026-11-14 feat: 航電艙更新至 avbay v0.10，新增 MCU 選型、元件選型總表與架構總覽
    - 機構：電池改為沿 X 前後排列、920 MHz 天線側掛（v0.9），
    層距改為 13.41 mm 配合 Samtec SFM／TFM 板對板堆疊接頭（v0.10）
    - 決策：新增 DEC-003 主備 MCU 提案（STM32F405RGT6、STM32L476RGT6），
    DEC-002 磁力計定為 MMC5983MA
    - 文件：新增元件選型總表，architecture.md 擴充為總覽入口，
    更新 MECH-001、研發路徑圖與機構說明
    [avbay_v0_10_ant_433.SLDPRT, avbay_v0_10_ant_920.SLDPRT, avbay_v0_10_ant_tracker.SLDPRT, avbay_v0_10_assembly.SLDASM, avbay_v0_10_bulkhead.SLDPRT, avbay_v0_10_cap.SLDPRT, avbay_v0_10_cell_18650.SLDPRT, avbay_v0_10_cell_cover.SLDPRT]
2026-11-14 docs: 新增任務徽章設計稿（mission patch v1 至 v3）
2026-11-14 docs: 新增協作流程範例
    以三個實際任務示範從開 Issue 到合併的每一步，並附上分支、commit、
    驗證與審查留言的寫法對照。
